mogenson/firefly-jar/README.md

# firefly-jar

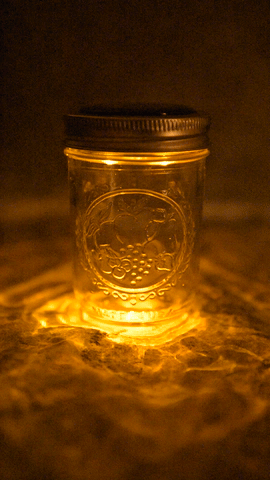
[picture p1: images/flicker-jar.gif]


KiCad sources for solar rechargeable flickering mason jar lamp.

Project documentation here: https://hackaday.io/project/8978-firefly-jar

2015 - Michael Mogenson
