mogenson/firefly-jar/Solar Lamp BOM.xlsx

Table 1
Part Name | Value | Notes | Package | Quantity | Schematic Ref | Price | Part Number | Link | Mouser alt link | subtotal
Solar Cell | 5V 40mA |  |  | 1 | U1 | $2.95 |  | http://www.adafruit.com/product/700 |  | $2.95
Diode | 1N5817 | 450 mV Vf | DO-41 | 1 |  | $0.38 | 1N5817DICT-ND | http://www.digikey.com/product-detail/en/1N5817-T/1N5817DICT-ND/190530
MOSFET | 1.7 Vgs(th), 2 Rds | P-Channel | TO-92 | 1 |  | $1.21 | TP0604N3-G-ND | http://www.digikey.com/product-search/en/discrete-semiconductor-products/fets-single/1376381?k=TP0604 |  | $1.21
Switch | DPDT | 300 mA |  | 1 |  | $0.41 | 401-2001-ND | http://www.digikey.com/product-detail/en/JS202011CQN/401-2001-ND/1640097 | http://www.mouser.com/ProductDetail/CK-Components/JS202011CQN/ | $0.41
LED | 2.1V 30mA | Candle flicker | 5mm | 2 |  | $0.55 |  | http://shop.evilmadscientist.com/productsmenu/partsmenu/353 |  | $1.10
Battery |  |  | AAA | 2 |  | $2.33 |  | http://www.onlybatteries.com/showitem.asp?ItemID=17950 |  | 4.66
Battery Holder | 2x AAA | 54.36 x 22.23 mm | AAA | 1 |  | $3.21 | 36-1077-ND | http://www.digikey.com/product-detail/en/1077/36-1077-ND/5118847 |  | $3.21
Resistor | 1M |  |  | 1 |  | $0.10 | CF14JT1M00CT-ND | http://www.digikey.com/product-detail/en/CF14JT1M00/CF14JT1M00CT-ND/1830423 |  | $0.10
Voltage Regulator | 2.1V 0.02V dropout at 30 mA |  | TO-92 | 1 |  | $0.40 | MCP1700-2102E-TO | http://www.mouser.com/ProductDetail/Microchip-Technology/MCP1700-2102E-TO/?qs=uHi2%2FQoPa5B%2FKH9GbYAWTA%3D%3D |  | $0.40
 |  |  |  |  | Total Price: | $14.04
