mogenson/firefly-jar/schematic.pdf

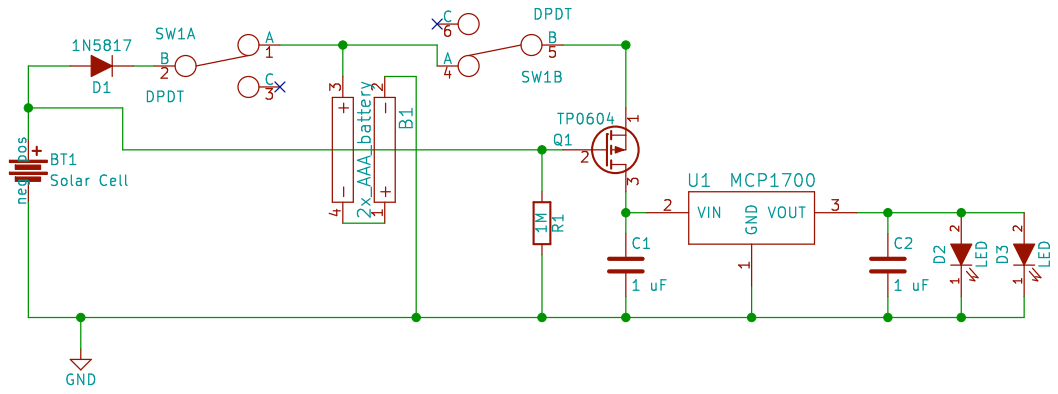
[picture p2: page 1]
