mogenson/firefly-jar/solar_lamp.kicad_pcb

## KiCad design solar_lamp.kicad_pcb (2015-12-29)

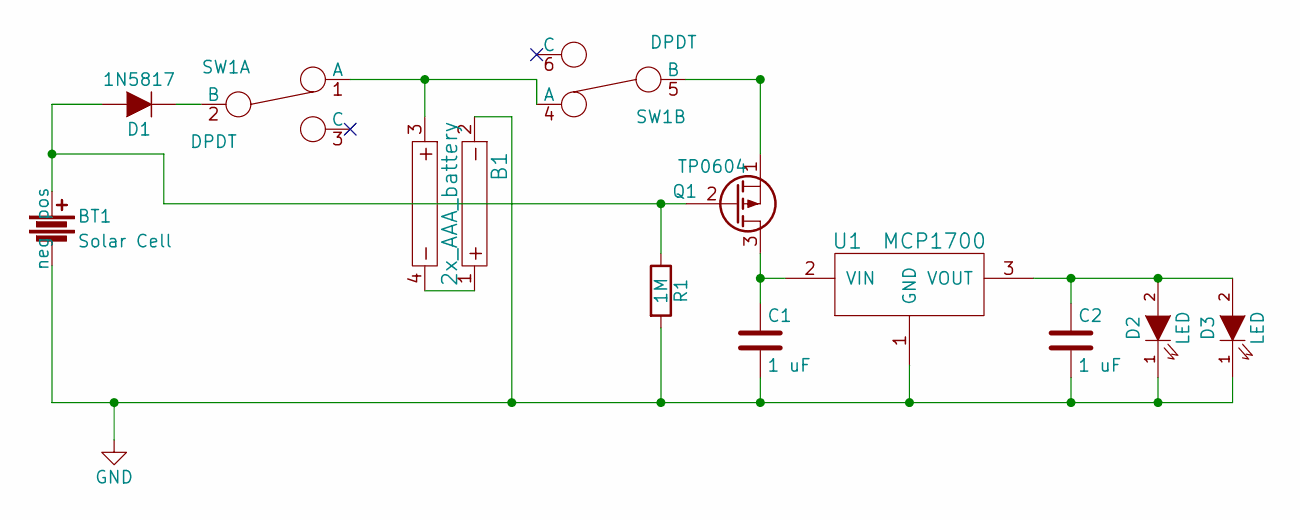
[picture p3: schematic solar_lamp.sch]

Parts:
B1: 2x_AAA_battery; Keystone_1077_2x_AAA_battery_holder
BT1: Solar Cell; Adafruit_round_solar_panel
C1, C2: 1 uF; C_Disc_D3_P2.5
D1: 1N5817; Diode_DO-41_SOD81_Horizontal_RM10
D2, D3: LED; LED-5MM
Q1: TP0604; TO-92_Inline_Narrow_Oval
R1: 1M; Resistor_Horizontal_RM10mm
SW1: DPDT; DPDT_JS202011CQN_switch
U1: MCP1700; TO-92_Inline_Narrow_Oval

Connections:
GND: B1.2, BT1.2 (neg), C1.2, C2.2, D2.1 (K), D3.1 (K), R1.2, U1.1 (GND)
unnamed: B1.1, B1.4
unnamed: B1.3, SW1.1 (A), SW1.4 (A)
unnamed: BT1.1 (pos), D1.2 (A), Q1.2 (G), R1.1
unnamed: C1.1, Q1.3 (D), U1.2 (VIN)
unnamed: C2.1, D2.2 (A), D3.2 (A), U1.3 (VOUT)
unnamed: D1.1 (K), SW1.2 (B)
unnamed: Q1.1 (S), SW1.5 (B)

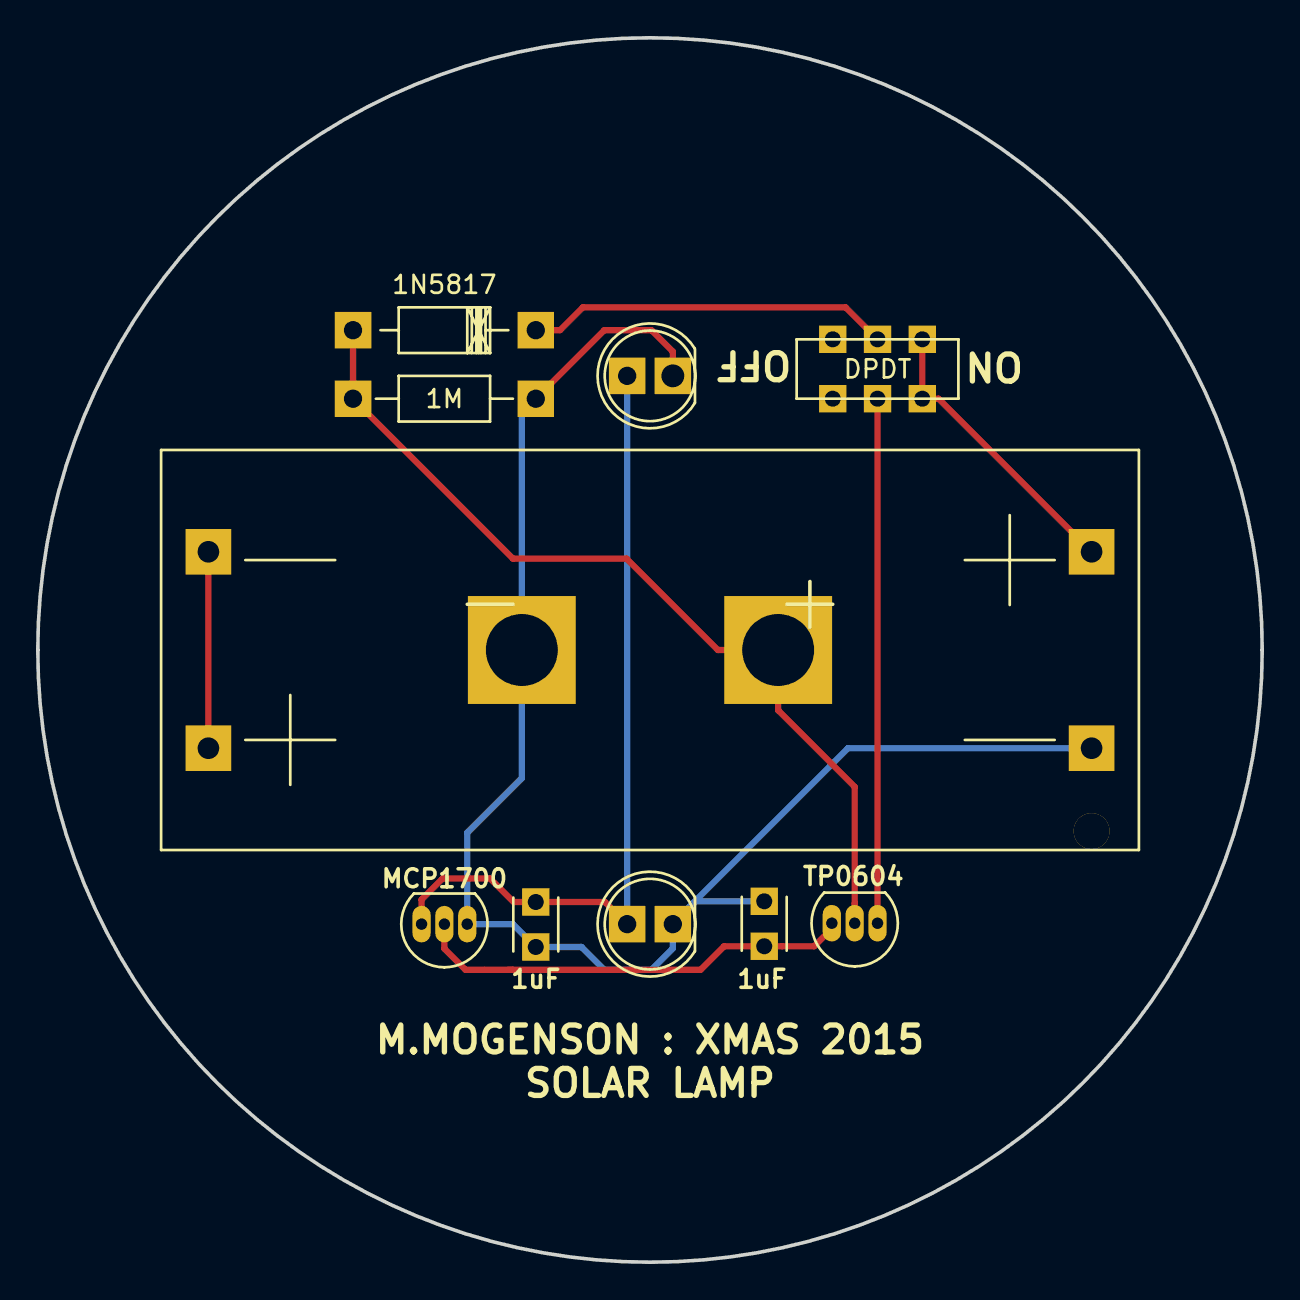
[picture p4: board solar_lamp.kicad_pcb from above]

Board: 2 copper layers, 68.1 x 68.1 mm, 11 parts (1 on the bottom side), 8 nets.
