mogenson/firefly-jar/(threads)

Thread 1 (2016-02-12):

Made one; won't turn on

Gyscos, 2016-02-12:
Hi - and bravo for this nice project!
I built one (using a PCB from dirtypcb), but it refuses to turn on, even in complete darkness.
The mosfet correctly outputs ~3.1V from the batteries (when I cover the solar cell), the voltage regulator outputs ~2.08V, but apparently it's not enough to lit up the leds. :-/
What could cause this?

mogenson, 2016-02-13:
Hey I'm sorry to hear that!

I also ran into this problem when I manufactured a second batch of these jar lid.  The solar cells from Adafruit were a different model from a different manufacturer and only about 50% of the jar lids worked.  I'm still looking into it.  I'm also trying to find a part number or a more direct source for the solar cell.

gyscos, 2017-08-30:
Problem seems to be the LED: specs say they work at 2.1V, but testing shows they need >2.3V to actually turn on. WIth a 2.1V LDO, it's no surprise it stays off...

mogenson, 2017-09-01:
Thank you for your testing. You should be able to replace the voltage regulator with a MCP1700-2302 or MCP1700-2502 at the expense of some battery life.

gyscos, 2017-09-01:
I thought about that, but with 2x 1.2v batteries, it won't reach the desired voltage often, so I'll try to use a 3.6v coin cell pack (3x 1.2v coin cells packed together).
